antelliJ/ereadEnclosure/PCB/production/ereader-bom.xlsx

Designator | Footprint | Quantity | Value | LCSC Part # | Alt Site | Comments
~~BT1~~ | ~~BatteryHolder_Lipo~~ | ~~1~~ | ~~Battery_Cell~~ |  |  | I plan on just wiring it
~~C1~~ | ~~603~~ | ~~1~~ | ~~10uF~~ | ~~C15850~~ |  | Usually Provided, alongside a thermistor that wasn't on the schematic
J1 | PinHeader_2x04_P2.54mm_Vertical | 1 | EPD-4.2in - 2x04 | C55829516
J2 | Molex_PicoBlade_53047-0810_1x08_P1.25mm_Vertical | 1 | remote | C240845
J3 | USB_C_Receptacle_GCT_USB4085 | 1 | USB_C_Receptacle_USB2.0_14P | C2765186
J4 | SPI-microsd-1x06 | 1 | SPI Micro SD card slot |  | https://www.aliexpress.com/item/1005008633757049.html | many of these ali express products are clones so find whichever make sthe most sense
R1, R2 | 603 | 2 | 5.1k | C23186
SW1 | PinHeader_1x03_P2.54mm_Horizontal | 1 | SW_SPDT | FILLER |  | A standard thru hole switch, no header needed
U1 | ESP32-S3-DevKitC | 1 | ESP32-S3-DevKitC |  | https://www.aliexpress.com/item/1005007319706057.html | standard s3 devkit
U2 | MCP73871 | 1 | MCP73871 |  | https://www.aliexpress.com/item/32779467674.html
U3 | Buck Boost 3v3 | 1 | Buck Boost Converter |  | https://www.aliexpress.com/item/1005006289357253.html
