antelliJ/ereadEnclosure/3dModel/editable/ereaderBase.FCStd

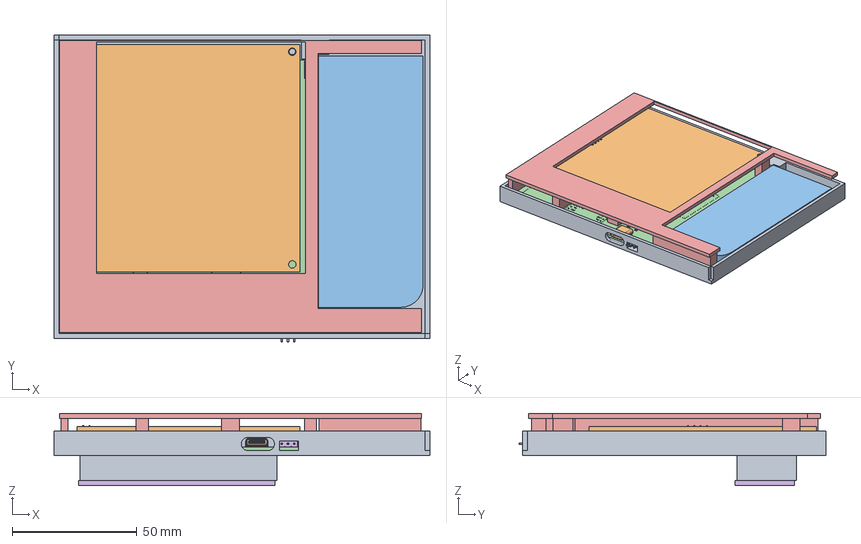
[picture p2: CAD file, 2026-11-02]
3dModel/editable/ereaderBase.FCStd
151.0 x 123.5 x 29.0 mm
Enclosure-Bottom
Screen
Remote
R_0603_1608Metric
R_0603_1608Metric009
PinHeader_1x03_P254mm_Horizontal001
PinHeader_1x06_P200mm_Vertical
C_0603_1608Metric
PinHeader_2x04_P254mm_Vertical001
USB_C_Receptacle_GCT_USB4085
ereA58_silkscreen
ereA58_PCB
Enclosure-Top
Battery-Cover
