antelliJ/ereadEnclosure/3dModel/printable/ereaderBase-Battery-Cover.3mf

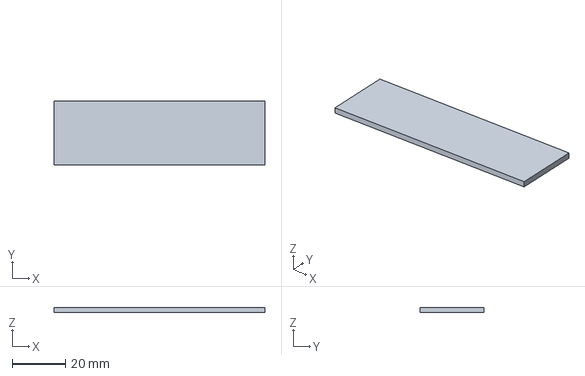
[picture p3: CAD file, 2026-11-02]
3dModel/printable/ereaderBase-Battery-Cover.3mf
79.0 x 24.0 x 2.00 mm
