antelliJ/ereadEnclosure/PCB/ereader pcb v2.step

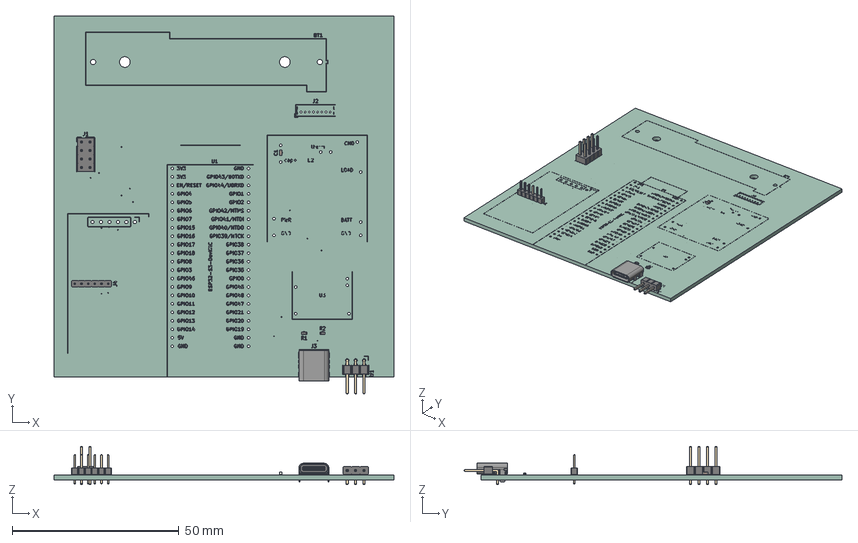
[picture p4: CAD file, 2026-11-01]
PCB/ereader pcb v2.step
102.0 x 113.3 x 11.5 mm
R_0603_1608Metric x 2
PinHeader_1x03_P254mm_Horizontal
PinHeader_1x06_P200mm_Vertical
C_0603_1608Metric
PinHeader_2x04_P254mm_Vertical
USB_C_Receptacle_GCT_USB4085
ereA58_silkscreen
ereA58_PCB
