antelliJ/ereadEnclosure/3dModel/printable/ereaderBase-Enclosure-Bottom.3mf

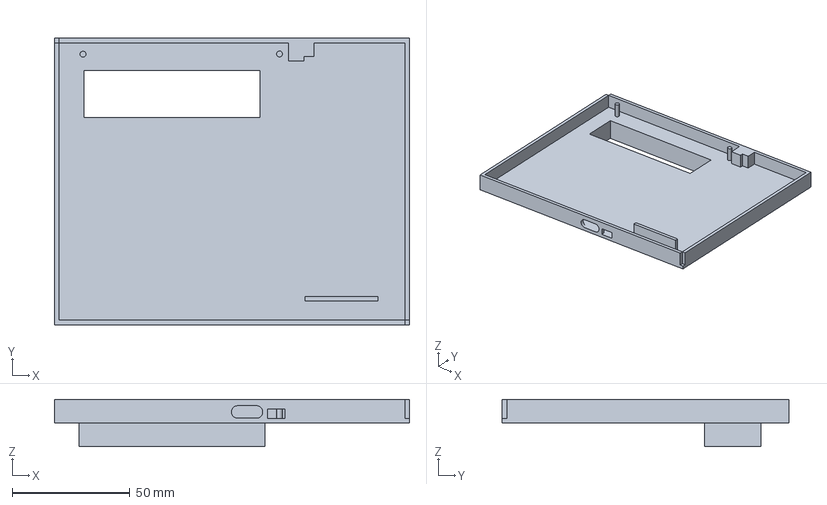
[picture p5: CAD file, 2026-11-02]
3dModel/printable/ereaderBase-Enclosure-Bottom.3mf
151.0 x 122.0 x 20.0 mm
