antelliJ/ereadEnclosure/PCB/ereader.step

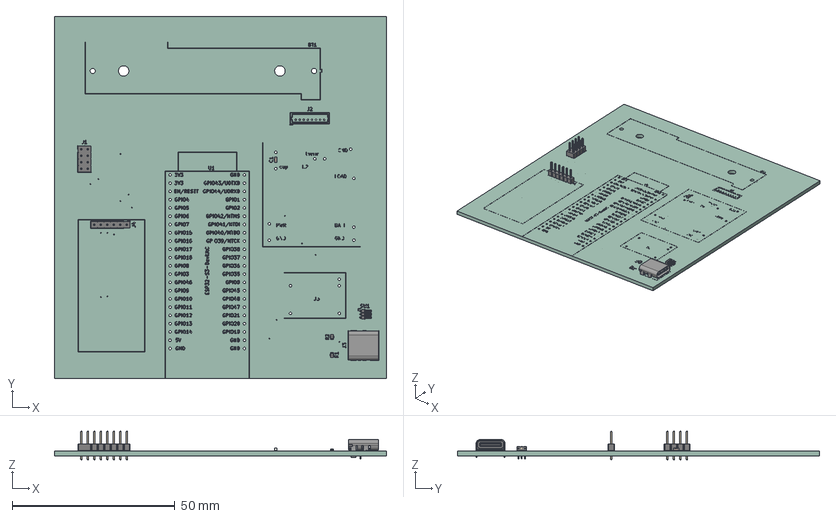
[picture p6: CAD file, 2026-11-01]
PCB/ereader.step
102.0 x 111.2 x 8.80 mm
R_0603_1608Metric x 2
PinHeader_1x03_P100mm_Horizontal
PinHeader_1x06_P200mm_Vertical
C_0603_1608Metric
PinHeader_2x04_P200mm_Vertical
USB_C_Receptacle_GCT_USB4085
ere63F9_silkscreen
ere63F9_PCB
