antelliJ/ereadEnclosure/3dModel/printable/ereaderBase.3mf

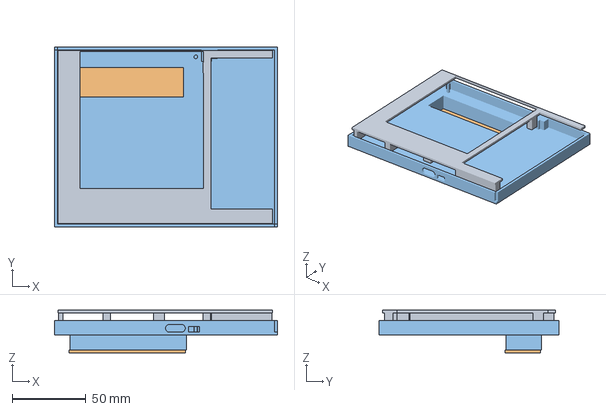
[picture p7: CAD file, 2026-11-02]
3dModel/printable/ereaderBase.3mf
151.0 x 122.0 x 29.0 mm
