antelliJ/ereadEnclosure/3dModel/printable/ereaderBase-Enclosure-Top.3mf

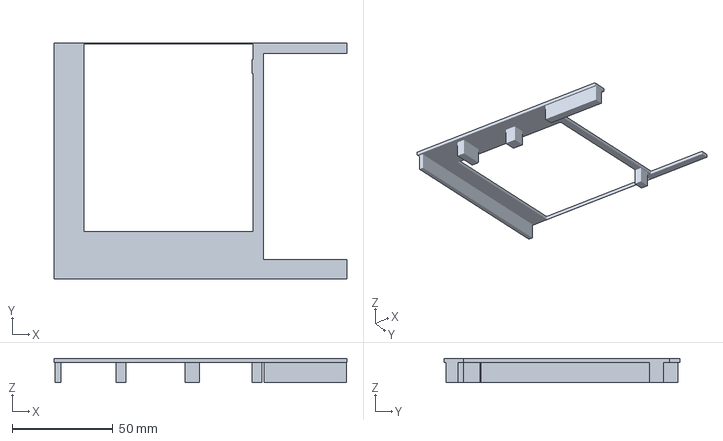
[picture p8: CAD file, 2026-11-02]
3dModel/printable/ereaderBase-Enclosure-Top.3mf
145.3 x 117.1 x 12.0 mm
