antelliJ/ereadEnclosure/PCB/ereader.kicad_pcb

## KiCad design PCB/ereader.kicad_pcb (2026-11-01)

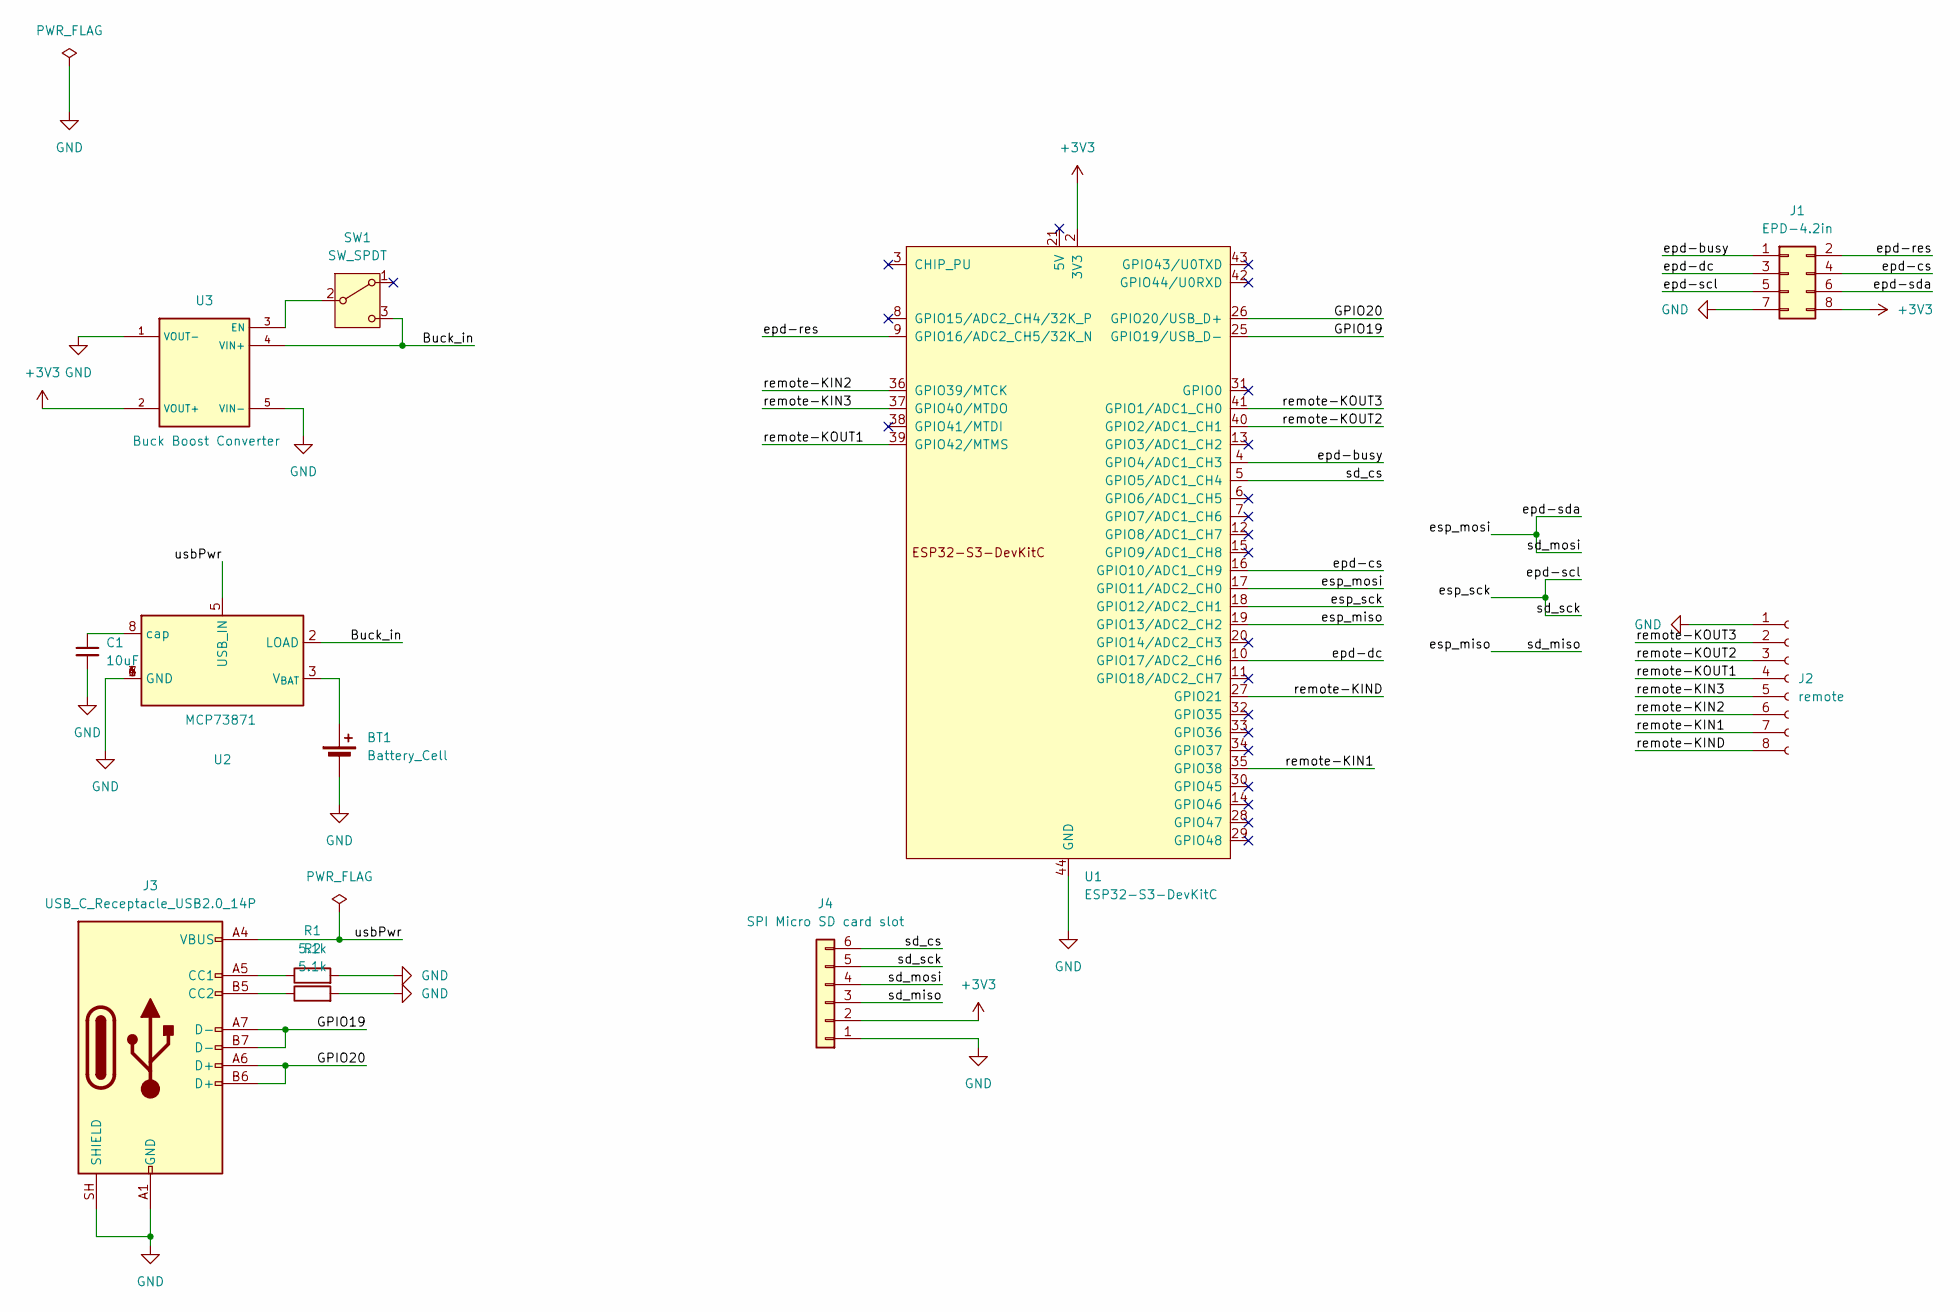
[picture p9: schematic ereader.kicad_sch]

Parts:
BT1: Battery_Cell; BatteryHolder_Lipo
C1: 10uF; C_0603_1608Metric_Pad1.08x0.95mm_HandSolder
J1: EPD-4.2in; PinHeader_2x04_P2.54mm_Vertical
J2: remote; Molex_PicoBlade_53047-0810_1x08_P1.25mm_Vertical
J3: USB_C_Receptacle_USB2.0_14P; USB_C_Receptacle_GCT_USB4085
J4: SPI Micro SD card slot; SPI-microsd-1x06
R1, R2: 5.1k; R_0603_1608Metric_Pad0.98x0.95mm_HandSolder
SW1: SW_SPDT; PinHeader_1x03_P2.54mm_Horizontal
U1: ESP32-S3-DevKitC
U2: MCP73871
U3: Buck Boost Converter; Buck Boost 3v3

Connections:
+3V3: J1.8, J4.2, U1.1 (3V3), U1.2 (3V3), U3.2 (VOUT+)
/Buck_in: SW1.3 (C), U2.2 (LOAD), U3.4 (VIN+)
/GPIO19: J3.A7 (D-), J3.B7 (D-), U1.25 (GPIO19/USB_D-)
/GPIO20: J3.A6 (D+), J3.B6 (D+), U1.26 (GPIO20/USB_D+)
/epd-busy: J1.1, U1.4 (GPIO4/ADC1_CH3)
/epd-cs: J1.4, U1.16 (GPIO10/ADC1_CH9)
/epd-dc: J1.3, U1.10 (GPIO17/ADC2_CH6)
/epd-res: J1.2, U1.9 (GPIO16/ADC2_CH5/32K_N)
/epd-scl: J1.5, J4.5, U1.18 (GPIO12/ADC2_CH1)
/epd-sda: J1.6, J4.4, U1.17 (GPIO11/ADC2_CH0)
/esp_miso: J4.3, U1.19 (GPIO13/ADC2_CH2)
/remote-KIN1: J2.7, U1.35 (GPIO38)
/remote-KIN2: J2.6, U1.36 (GPIO39/MTCK)
/remote-KIN3: J2.5, U1.37 (GPIO40/MTDO)
/remote-KIND: J2.8, U1.27 (GPIO21)
/remote-KOUT1: J2.4, U1.39 (GPIO42/MTMS)
/remote-KOUT2: J2.3, U1.40 (GPIO2/ADC1_CH1)
/remote-KOUT3: J2.2, U1.41 (GPIO1/ADC1_CH0)
/sd_cs: J4.6, U1.5 (GPIO5/ADC1_CH4)
/usbPwr: J3.A4 (VBUS), J3.A9 (VBUS), J3.B4 (VBUS), J3.B9 (VBUS), U2.5 (USB_IN)
GND: BT1.2 (-), C1.2, J1.7, J2.1, J3.A1 (GND), J3.A12 (GND), J3.B1 (GND), J3.B12 (GND), J3.SH (SHIELD), J4.1, R1.2, R2.2, U1.22 (GND), U1.23 (GND), U1.24 (GND), U1.44 (GND), U2.1 (GND), U2.4 (GND), U2.6 (GND), U2.7 (GND), U3.1 (VOUT-), U3.5 (VIN-)
unnamed: BT1.1 (+), U2.3 (V_{BAT})
unnamed: J3.A5 (CC1), R1.1
unnamed: J3.B5 (CC2), R2.1
unnamed: SW1.2 (B), U3.3 (EN)
unnamed: C1.1, U2.8 (cap)

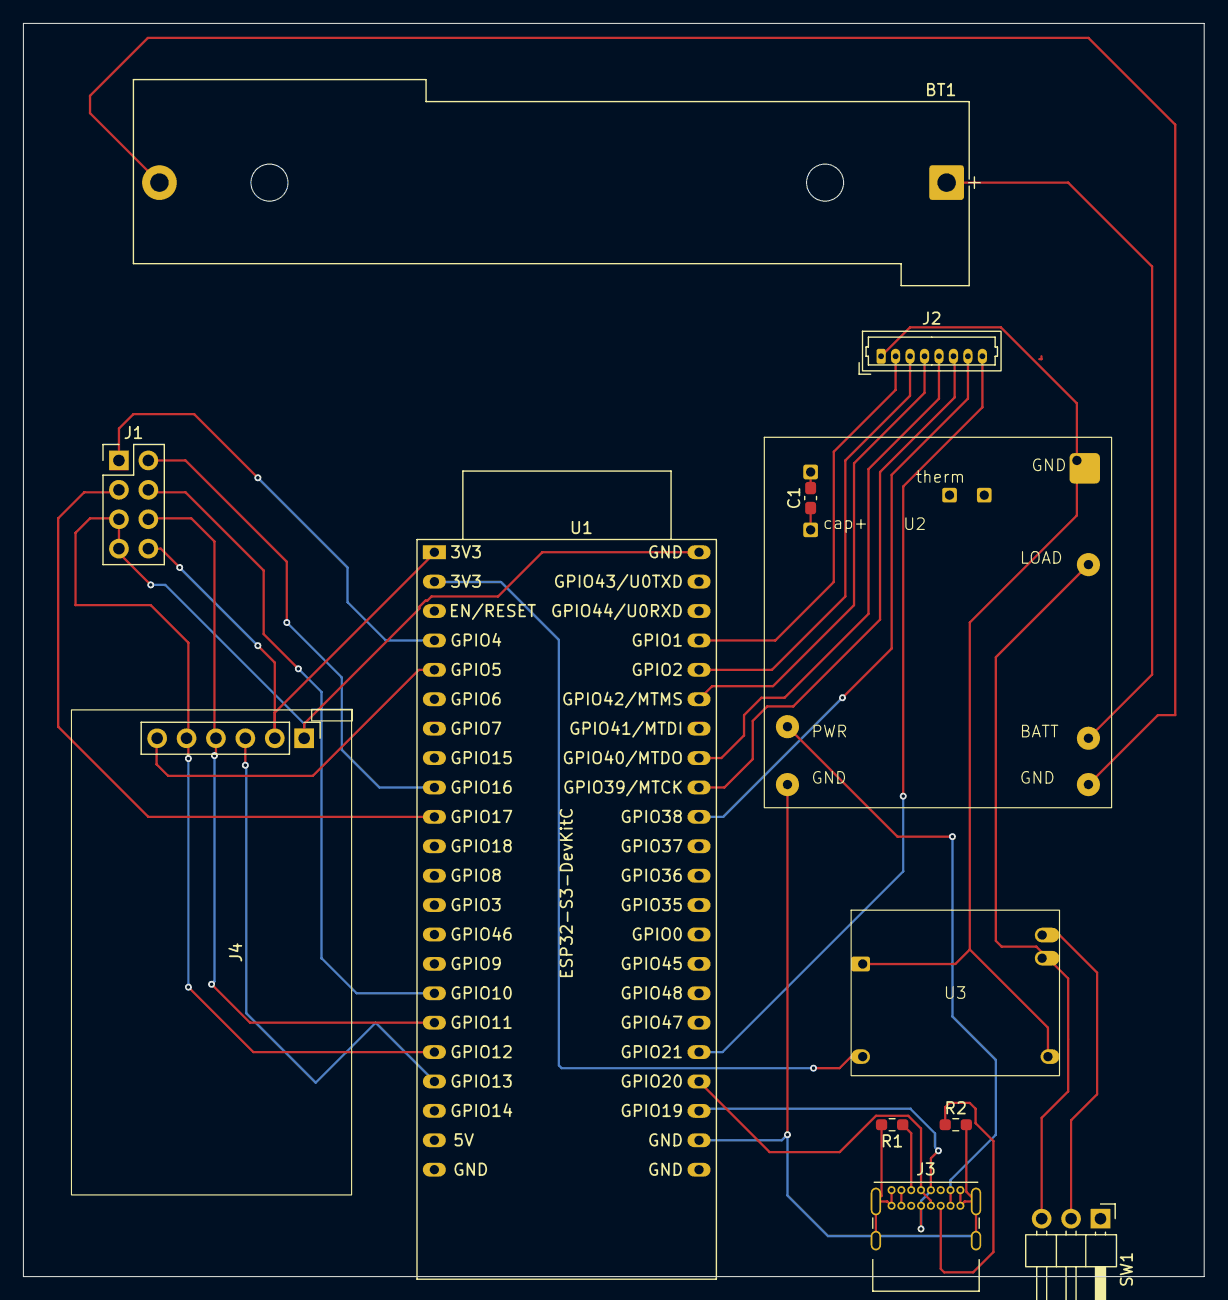
[picture p10: board ereader.kicad_pcb from above]

Board: 2 copper layers, 102.0 x 108.2 mm, 12 parts (0 on the bottom side), 26 nets.
