antelliJ/ereadEnclosure/(commit log)

2026-11-01 Created and routed PCB, started modelling enclosure
    [ereader pcb v2.step, ereader.kicad_pcb, ereader.kicad_sch, ereader.step, ereaderBase.FCStd]
2026-11-02 Added ereader code and updated readme and model
    [ereader-bom.xlsx, ereaderBase-Battery-Cover.3mf, ereaderBase-Enclosure-Bottom.3mf, ereaderBase-Enclosure-Top.3mf, ereaderBase.3mf, ereaderBase.FCStd]
2026-11-02 Enhance README with PCB and file structure information images
    Updated README to clarify PCB and file structure details.
